jasoncheng7115/JTUSBKVM/screenshot/3 linux.png

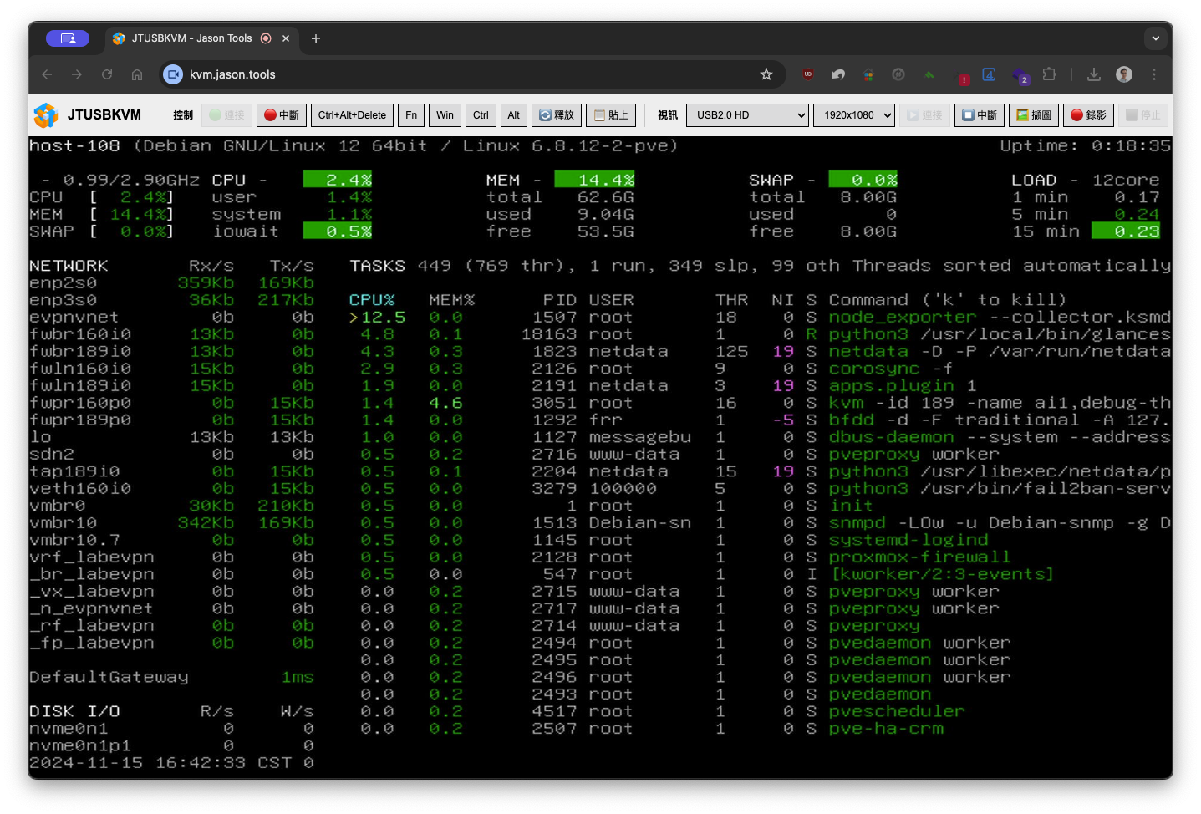
screenshot/3 linux.png
