jasoncheng7115/JTUSBKVM/screenshot/4 windows.png

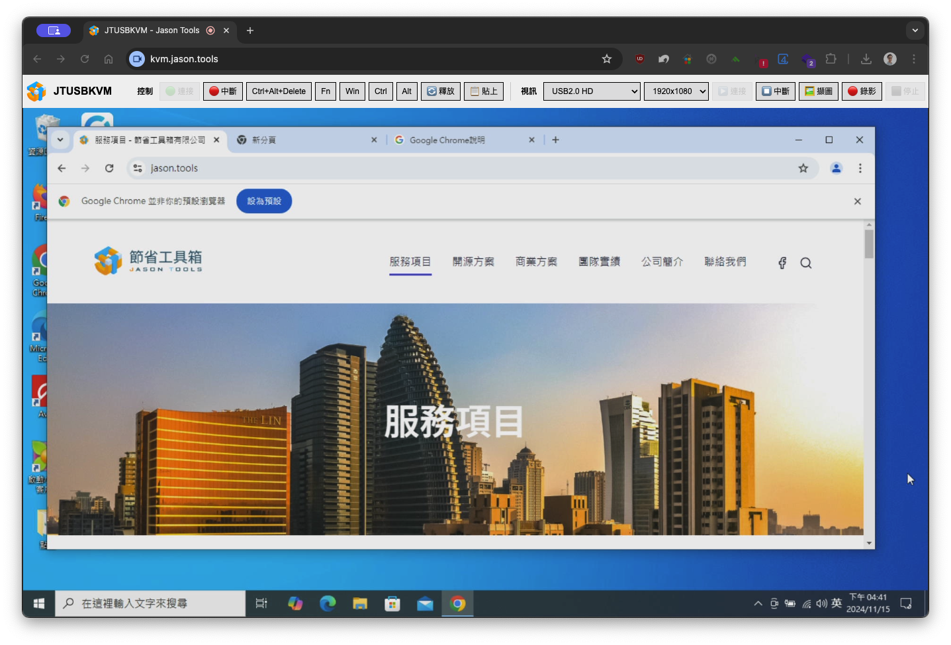
screenshot/4 windows.png
