jasoncheng7115/JTUSBKVM/screenshot/console_cisco.png

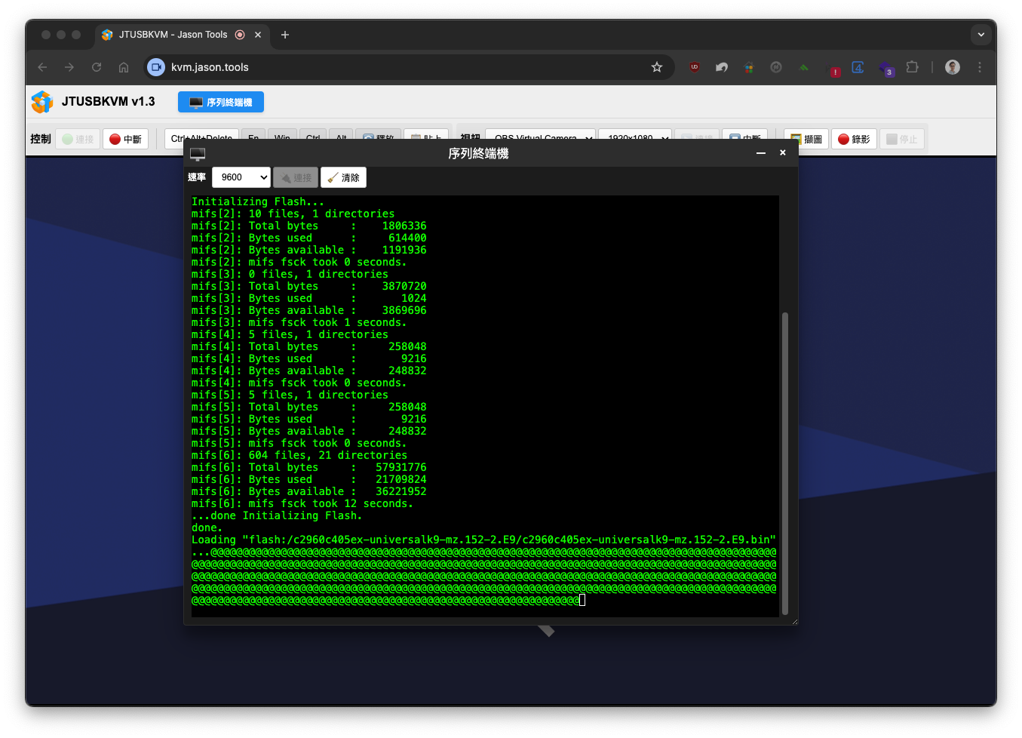
screenshot/console_cisco.png
