jasoncheng7115/JTUSBKVM/screenshot/console_mikrotik_1.png

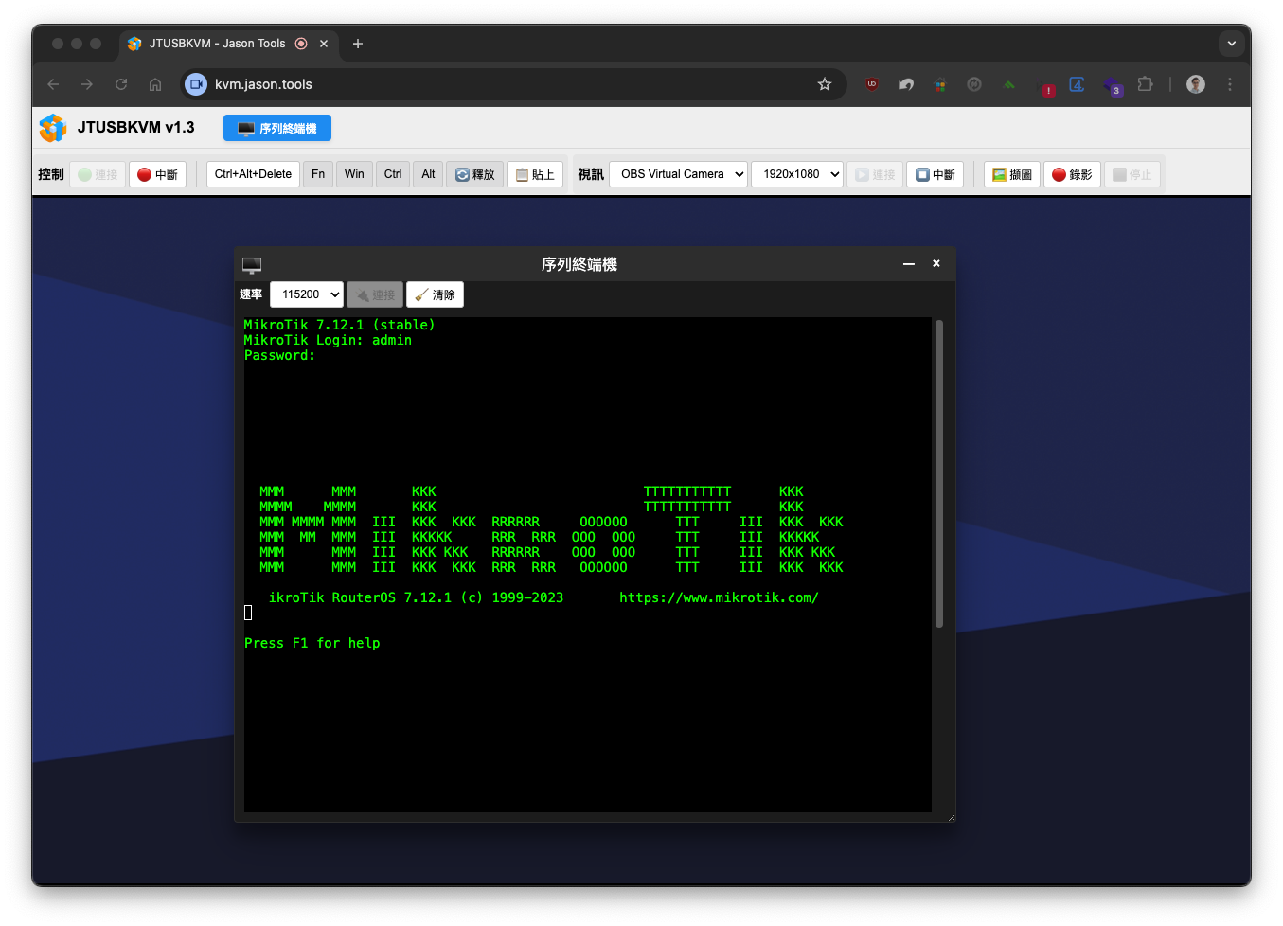
screenshot/console_mikrotik_1.png
