jasoncheng7115/JTUSBKVM/(commit log)

2024-11-17 Rename 1 全配.JPG to screenshot/1 全配.JPG
2024-11-26 加入序列終端機支援、介面調整、處理機制改善
2024-11-26 序列終端機所須套件 xterm.js
2024-11-26 標題列 logo 圖檔
2024-11-26 加入 logo、xterm.js 下載處理
2024-11-26 加入 RS232 功能 (console 線用途)
2024-11-26 加入序列終端機功能說明
2024-11-26 修正問題、加入放大縮小功能
2024-12-01 序列終端機加入換行選擇
2024-12-02 調整啟動後的 USB Serial 等待行為
2025-05-10 加入接線表
2025-05-11 修正檔案字元編碼
2025-05-11 更新本機使用說明
2025-05-11 免責聲明
2025-05-12 修正編碼問題、執行路徑問題、權限檢查
2025-05-12 預設 openssl 路徑
2026-09-11 接線示意圖
