jasoncheng7115/JTUSBKVM/(notices)

Notices in the files:
arduino/b_arduino.ino:
This program is free software: you can redistribute it and/or modify
it under the terms of the GNU Affero General Public License as published
